ipavlex/ltc-reader-nano/(commit log)

2026-09-21 LTC Reader Nano: декодер SMPTE LTC (Nano + MAX7219)
    - аппаратный захват: компаратор + Timer1 Input Capture (0.5 мкс)
    - bi-phase mark декодер, авто-fps 24/25/30, BCD-парсер SMPTE 12M
    - вывод HH.MM.SS.FF на 8-разрядный MAX7219 (прямой SPI, без библиотек)
    - фильтр правдоподобия, ресинк после паузы, сторож ре-инита
    - опциональный DEBUG-лог + утилиты в tools/
    - README, схема, PLAN.md, журнал отладки, лицензия MIT
2026-09-21 Удалён тестовый скетч max7219_test
2026-09-21 Удалены PLAN.md и DEBUG_STATUS.md, ссылки вычищены
2026-09-21 Схема: только scheme.svg, PNG удалён
